dandamaria/Sistema-Ball-and-Beam/README.md

# Sistema-Ball-and-Beam
Aplicação do controle PID no sistema ball and beam.
