dandamaria/Sistema-Ball-and-Beam/(commit log)

2025-10-25 Add files via upload
    código para testar o servo-motor e setar sua posição inicial.
2025-10-25 Add files via upload
    teste para verificar se os sensores ultrassônicos estão lendo as distâncias corretamente
2026-06-10 Documento de Pesquisa e apresentação do trabalho
    status: concluído em 2025
